onmokoworks/onmk.videosynth.01/README.md

# onmk.videosynth.01

制作中のビデオシンセ。

| フォルダ | 内容 |
|---|---|
| `emulator/` | ブラウザで動くエミュレーター、シェーダーエディタ、つまみの割り当て（`index.html` を Chrome で開く） |
| `shaders/` | シェーダーと割り当て（`index.js`） |
| `docs/` | 配線図（`wiring.html`）、パネル部品の位置（`panel_controls.json`） |
| `hardware/layout/` | パネルの配置 |
| `hardware/panel_topplates/` | 天板の図面（DXF / SVG / STL / STEP） |
| `hardware/laser_acrylic/` | アクリルのレーザーカット用データ |
| `hardware/enclosure_3dp/` | 3D プリントの箱（STL、生成スクリプト） |
| `hardware/knobs_keycaps/` | ノブとキーキャップの生成スクリプト |
| `AGENTS.md` | コーディングエージェント向けの指示書 |
