onmokoworks/onmk.videosynth.01/hardware/laser_acrylic/README.txt

アクリル 3mm レーザーカット v02（2026-10-27、配置 = layout_v08d_geisai.json：メインのトグルを左上へ＝電源、左上のノブを元のトグル位置へ）
カット線: 赤 #FF0000・線幅 0.01mm・塗りなし。刻印: 黒の文字（試し板のサイズ表示だけ）。
学校のルール（色・線幅）が違ったら Illustrator で一括置換してから .ai 保存。
00_test_coupon_130x78.svg  試し板。最初に切って、部品がはまる穴サイズを確認
01_white_matte_top_bottom_300x450.svg  白両面マット: 天板3枚＋底板3枚
02_opal_matte_LED_ring_300x450.svg     乳半両面マット: LED 層の枠3枚（幅10mm）
穴はレーザーの削れ分の補正なし（kerf 0）。試し板の結果で source/laser_layout.py --kerf を決めて作り直す。
