onmokoworks/onmk.videosynth.01/hardware/enclosure_3dp/box_main_120x140.stl

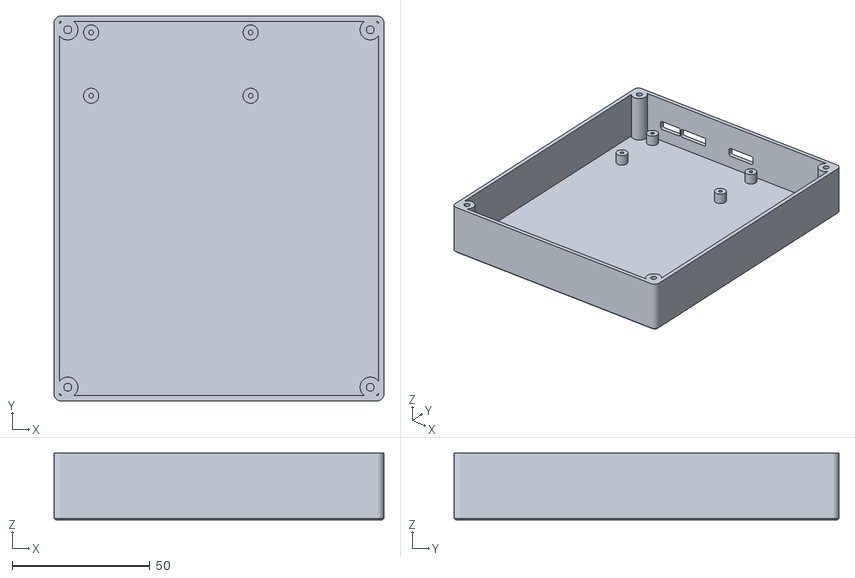
[picture p1: CAD file, 2026-10-28]
hardware/enclosure_3dp/box_main_120x140.stl
120.0 x 140.0 x 24.3
