onmokoworks/onmk.videosynth.01/hardware/panel_topplates/01_topplate_main_120x140_t3mm.step

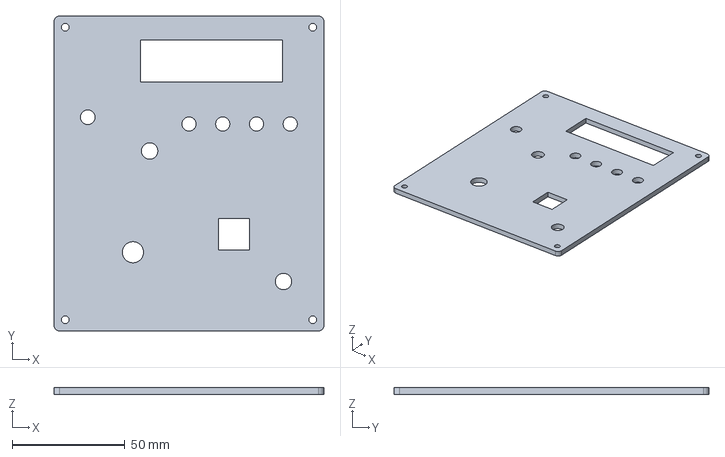
[picture p2: CAD file, 2026-10-28]
hardware/panel_topplates/01_topplate_main_120x140_t3mm.step
120.0 x 140.0 x 3.00 mm
