onmokoworks/onmk.videosynth.01/hardware/enclosure_3dp/box_faders_110x105.stl

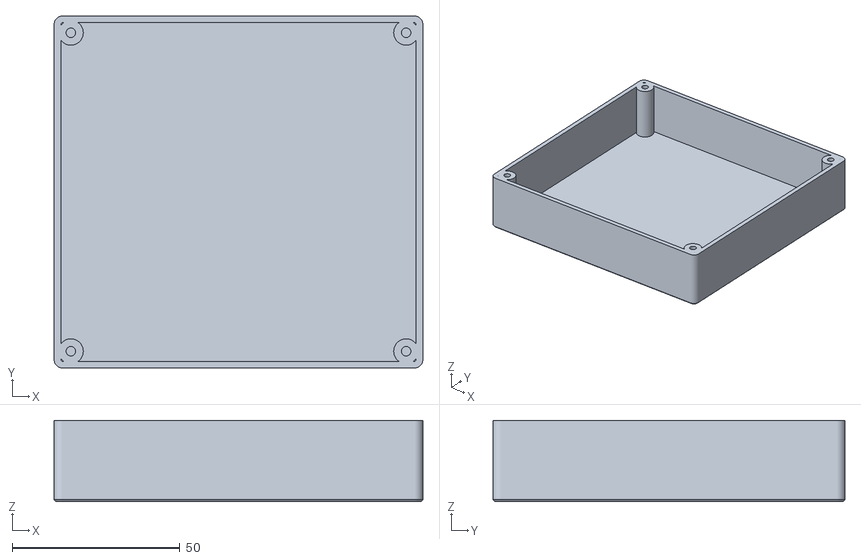
[picture p3: CAD file, 2026-10-28]
hardware/enclosure_3dp/box_faders_110x105.stl
110.0 x 105.0 x 24.3
