onmokoworks/onmk.videosynth.01/hardware/knobs_keycaps/keycap_form_v03_x2.stl

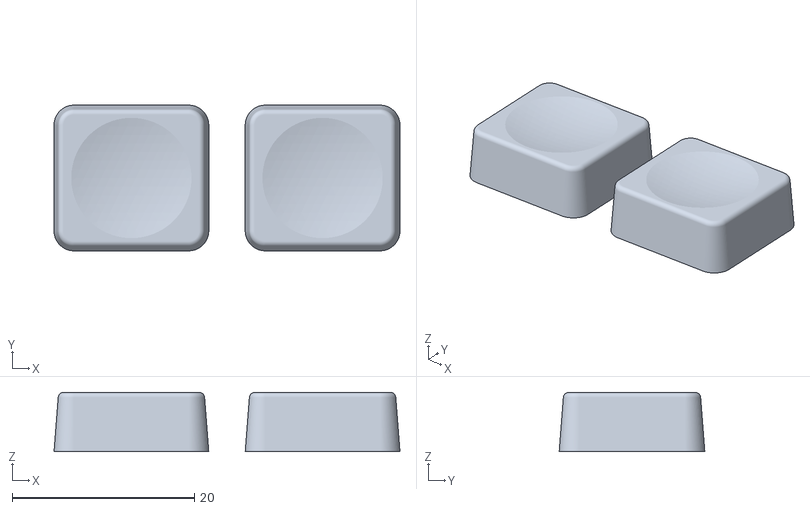
[picture p4: CAD file, 2026-10-28]
hardware/knobs_keycaps/keycap_form_v03_x2.stl
38.0 x 16.0 x 6.50
