onmokoworks/onmk.videosynth.01/hardware/panel_topplates/02_topplate_faders_110x105_t3mm.step

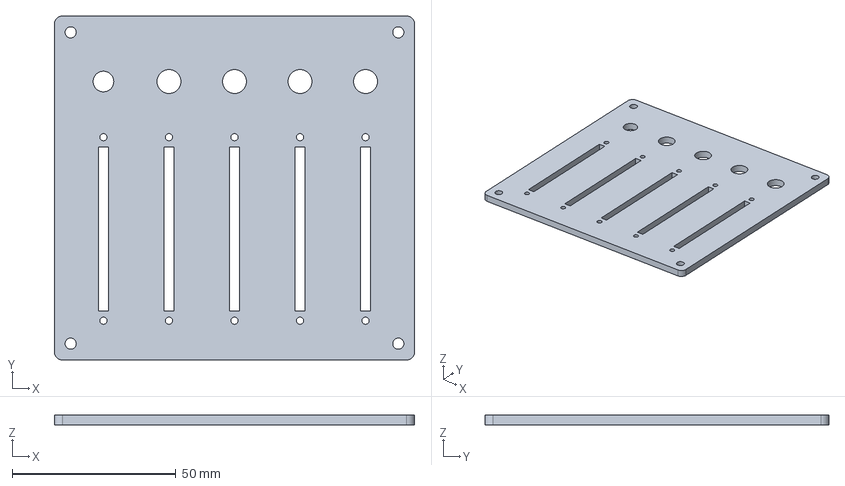
[picture p5: CAD file, 2026-10-28]
hardware/panel_topplates/02_topplate_faders_110x105_t3mm.step
110.0 x 105.0 x 3.00 mm
