onmokoworks/onmk.videosynth.01/hardware/panel_topplates/03_topplate_keys_115x80_t3mm.step

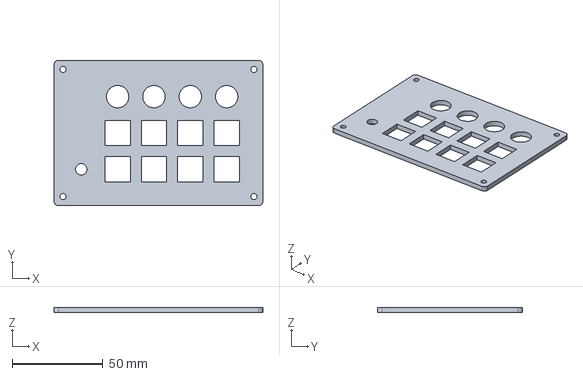
[picture p6: CAD file, 2026-10-28]
hardware/panel_topplates/03_topplate_keys_115x80_t3mm.step
115.0 x 80.0 x 3.00 mm
