onmokoworks/onmk.videosynth.01/hardware/enclosure_3dp/box_keys_115x80.stl

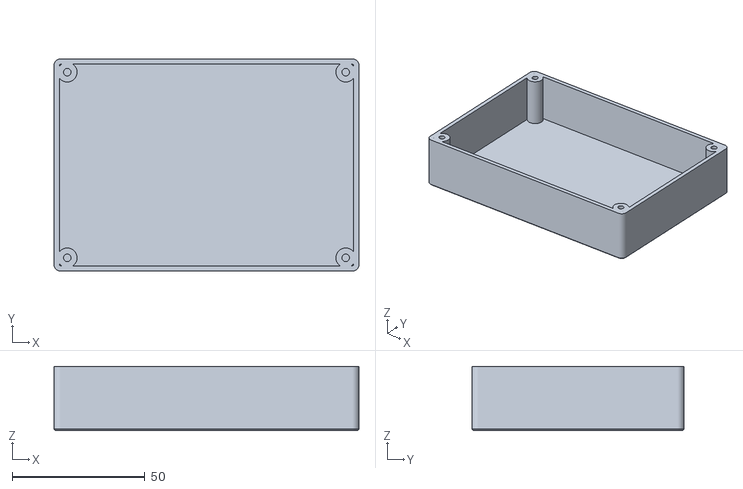
[picture p7: CAD file, 2026-10-28]
hardware/enclosure_3dp/box_keys_115x80.stl
115.0 x 80.0 x 24.3
