onmokoworks/onmk.videosynth.01/(list of files, cad)

Other CAD files:
hardware/panel_topplates/01_topplate_main_120x140_t3mm.dxf
hardware/panel_topplates/01_topplate_main_120x140_t3mm.stl
hardware/panel_topplates/02_topplate_faders_110x105_t3mm.dxf
hardware/panel_topplates/02_topplate_faders_110x105_t3mm.stl
hardware/panel_topplates/03_topplate_keys_115x80_t3mm.dxf
hardware/panel_topplates/03_topplate_keys_115x80_t3mm.stl
