onmokoworks/onmk.videosynth.01/docs/wiring.html

# Vs-01 配線図

2026-10-28 版（v3.1：パネル配置 v09・firmware/ に合わせた。キー箱のピンをヘッダ上側に集めた）。箱ごとにマイコンを入れて、DATA ケーブル（3.5mm ステレオ）で値をメインに集め、Pi Zero v1.3 が GLSL で映像を作る構成。

[フェーダー箱] Pico ＋ 74HC4067 ノブ4・フェーダー5 │ DATA 1 ケーブル：先端 = 信号（箱 → メイン）／中間 = 5V（メイン → 箱）／根元 = GND [キー箱] RP2350-PiZero キー12（上の段の4つは TAP として使う。全部ボタンなのでアナログ入力はいらない） │ DATA 3 ケーブル：同じ [メイン] Pico ノブ1・GOOD KNOB（エンコーダー）・RESET・トグル SW2 ＋ 横の箱の値をまとめる │ UART（TX と GND の2本） [メイン] Pi Zero v1.3 シェーダー → HDMI、小さい液晶（TFT）も Pi Zero が表示 [メイン] USB-C 電源入口 → POWER トグル → 5V（全部に配る）

3.3V5VGNDアナログ（ノブ・フェーダー）デジタル（キー・エンコーダー・切り替え）シリアル（UART）・液晶

図の中の 3V3 / 5V / GND の小さな札は「同じ名前の札どうしは全部つながっている」という意味（線を全部描くと見づらいので省略）。

守ること・決まりごと

- 手持ちのジャックの足番号：1 = 根元（GND）・2 = 先端（信号）・3 = 中間（5V）（10/28 にプラグを挿して確認）
- 電源を入れたままの抜き挿し OK にするため、メイン側の 5V はジャックごとに ポリスイッチ＋33Ω、信号線は両端に 2.2kΩ。挿す瞬間に線どうしが触れても、流れる電流が小さく抑えられて壊れない。モノラル（2極）のケーブルを挿してしまっても同じく守られる（ただし動かない）。
- ノブ・フェーダーの端は 3.3V につなぐ（5V はだめ）。
- 横の箱は、DATA の 5V → ショットキーダイオード → 電源入力。帯のある側を基板側に。USB を挿したまま動かしても逆流しない。
- DATA ケーブルはステレオ（3極）。ユーロラックの黄色いケーブル（モノラル）では動かない。
- 箱の柱に載せて端子を壁の穴に合わせるのは Pi Zero。メインの Pico は箱の中の空いた所に両面テープで固定。
- Pi Zero は電源を急に切られても壊れないよう読み込み専用にする（再生プログラムを入れるときに設定）。

## 1. フェーダー箱（Pico ＋ 74HC4067）

### 74HC4067 モジュール

モジュール | Pico
VCC | 3V3(OUT) 36番ピン（すぐそばに 100nF を VCC–GND 間に）
GND | GND
EN | GND（常に有効）
S0 / S1 / S2 / S3 | GP2 / GP3 / GP4 / GP5
SIG | GP26（ADC0）31番ピン

買うのは「74HC4067」（HCT ではない方）。

### ノブ・フェーダー → 74HC4067

部品 | チャンネル
ノブ 0〜3（左から） | C0 / C1 / C2 / C3
フェーダー 0〜4（左から） | C4 / C5 / C6 / C7 / C8

それぞれ3本足：片端 → 3V3、反対の端 → GND、ワイパー → チャンネル。どの足がワイパーかはテスターで確かめる（真ん中とは限らない）。回す向きが逆なら端の2本を入れ替える。

### DATA 1 ジャック

ジャック | Pico
先端（Tip） | 2.2kΩ → GP0（UART0 TX）1番ピン
中間（Ring） | ダイオード（帯が Pico 側）→ VSYS 39番ピン
根元（Sleeve） | GND

## 2. キー箱（RP2350-PiZero）

GP 番号は RP2350 のピン番号。40ピンの物理番号や Pi の GPIO 番号とは別物なので、基板の印刷（GP○○）を見てつなぐ。

### キー・TAP

部品 | RP2350-PiZero
上の段（左から）＝ TAP 0〜3 | GP5 / GP7 / GP9 / GP21
真ん中の段（左から）＝ キー 0〜3 | GP18 / GP8 / GP1 / GP20
下の段（左から）＝ キー 4〜7 | GP22 / GP23 / GP24 / GP11

10/29 に短い線で配線し直した実際のピン（1つずつ押して確認済み）。全部のキーの上側の足を GND の数珠つなぎ、下側の足をそれぞれの GP へ。GND は各段（上・中・下）からボードの GND へ1本ずつ（段の間の渡り線だけだと切れやすい。10/28 に上・中段が無反応→各段直結で解決、12キー全部 OK）。

スイッチの片足 → GP、もう片足 → GND。抵抗はいらない（内蔵のプルアップを使う）。基板にその GP が出ていなければ、空いている別の GP に変えて教えてください（プログラム側で合わせます）。

### DATA 3 ジャック

ジャック | RP2350-PiZero
先端 | 2.2kΩ → GP0（UART0 TX）
中間 | ダイオード（帯が基板側）→ 5V ピン
根元 | GND

## 3. メイン（Pico ＋ Pi Zero v1.3）

### Pico：メインのつまみ

部品 | Pico
ノブ（1つだけ）ワイパー | GP26（ADC0）31番
トグル SW2（右下のもう1つのトグル） | GP19 25番 ／ もう片足 GND
ノブの両端 | 3V3(OUT) 36番 と GND
GOOD KNOB（RE160F）A / B | GP16 / GP17 21・22番
GOOD KNOB の C（共通） | GND（C の足は端子図とテスターで確認）
RESET キー | GP18 24番 ／ もう片足 GND

### Pico：DATA ジャック

ジャック | つなぎ先
DATA 1 先端（フェーダー箱から） | 2.2kΩ → GP1（UART0 RX）2番
DATA 3 先端（キー箱から） | 2.2kΩ → GP5（UART1 RX）7番
DATA 1・3 中間 | 5V → ポリスイッチ MF-RX020 → 33Ω（1/2W） → 中間（ジャックごとに1組）
DATA 1・3 根元 | GND
DATA 7・8 | 何もつながない（予備）

### Pico → Pi Zero

Pico | Pi Zero（40ピン）
GP0（UART0 TX）1番 | GPIO15 / RXD 10番ピン
GND | GND 6番ピン

### 小さい液晶（ST7789 2.25"）→ Pi Zero

液晶 | Pi Zero（40ピン）
VCC | 3V3 17番
GND | GND 20番
SCL / SCK | GPIO11 23番
SDA / MOSI | GPIO10 19番
CS | GPIO8 / CE0 24番
DC | GPIO25 22番
RES | GPIO24 18番
BLK（バックライト） | GPIO18 12番（つながなくても点く型が多い）

シェーダー名や GOOD の値は Pi Zero が知っているので、液晶も Pi Zero が表示する。

### 電源

から | へ
USB-C 電源モジュール 5V | POWER トグルの片側
POWER トグルのもう片側（＝5V） | Pi Zero 5V 2番、メイン Pico VSYS 39番、DATA 用ポリスイッチ
USB-C 電源モジュール GND | 全部の GND

5V 2A 以上の USB 充電器。電源の入口のそばに 10〜47µF のコンデンサがあると安定する。
Pi Zero を 5V ピンから給電している間は、Pi Zero の micro USB には何も挿さない。

## 4. 送るデータの形（プログラム用）

どこ → どこ | 形 | 頻度
フェーダー箱 → メイン | F,k2,k3,k4,k5,f0,f1,f2,f3,f4\n（0〜4095、ノブは全体の番号 2〜5） | 50 回/秒
キー箱 → メイン | K,<12桁の0/1>\n（キー0〜11、押している所が 1。0〜3 が TAP） | 変化したとき＋10 回/秒
メイン Pico → Pi Zero | V,k0..k5,f0..f4,keys,taps,enc,reset,sw2\n（17項目。ノブ・フェーダーは 0〜1、k1 は 0.5 固定、enc は回した段数の合計。u_good = enc/24） | 60 回/秒

どれも 115200bps・8N1。Pi Zero v1.3 の GPIO15 は本物の UART（ttyAMA0）：enable_uart=1、シリアルコンソールは切る。

読み取りのコツ（プログラム側）：74HC4067 は切り替えて 20µs 待ち、1回捨ててから数回平均。エンコーダーは A/B の状態変化で数える。

## 5. 買い足すもの

- 74HC4067 モジュール ×1（予備込みで2）— フェーダー箱
- USB-C 電源モジュール（5V を取り出すだけ） ×1 — 電源入口
- 2.2kΩ 抵抗 ×4、33Ω 抵抗（1/2W） ×2、ショットキーダイオード（1N5817 など）×2、100nF ×1、10〜47µF ×2〜3
- メス-メスのジャンパ線、細い配線用の線
- （手持ち）Pico ×2、RP2350-PiZero、Pi Zero v1.3（10/28 着）、ポリスイッチ MF-RX020、3.5mm ステレオジャック
