onmokoworks/onmk.videosynth.01/(commit log)

2026-10-28 Vs-01: emulator, shader editor and mapping, shaders, wiring diagrams, hardware files
    - emulator/: browser emulator of the three panels (desk view, patch cables, POWER, GOOD KNOB),
    GLSL editor with live compile and highlighting, map tab for p_* params
    - shaders/: GOOD, BARS, FEEDBACK, PLASMA (GLSL ES 1.00, u_good everywhere)
    - docs/: wiring.html (v2, after review), panel_controls.json/js
    - hardware/: layout v08d, 3 mm top plates, laser sheets v02, 3D-printed boxes, knob/keycap scripts
    - AGENTS.md: shader contract, GOOD KNOB rules, mapping rules, tasks
    [01_topplate_main_120x140_t3mm.dxf, 01_topplate_main_120x140_t3mm.step, 01_topplate_main_120x140_t3mm.stl, 02_topplate_faders_110x105_t3mm.dxf, 02_topplate_faders_110x105_t3mm.step, 02_topplate_faders_110x105_t3mm.stl, 03_topplate_keys_115x80_t3mm.dxf, 03_topplate_keys_115x80_t3mm.step]
2026-10-28 README を日本語に
2026-10-28 README を中身の一覧だけに
2026-10-28 エミュレーター：四隅のネジを六角、フェーダーの M2 ネジを表示
2026-10-28 Add v09 MicroPython control-board firmware and host tests
2026-10-28 TRUCHET main shader (woven layers, scrolling, flip cards); wiring v3 for panel layout v09
2026-10-28 wiring: keys box pins moved to the top rows of the header
2026-10-28 wiring: note the jack pin numbers (1 sleeve, 2 tip, 3 ring)
2026-10-28 wiring: keys box GND goes from every row to the board; 12 keys verified
2026-10-29 wiring: key layout (front/back) and RP2350-PiZero header map diagram
2026-10-29 keys: pins as rewired on 10/29 (GP5/7/9/21, 18/8/1/20, 22/23/24/11), UART RX parked on GP13
2026-10-29 TRUCHET: balls hang under the lower edge of their band (cable-car), measured along the real hanging path
2026-10-29 wiring: Pi Zero header diagram (top view, pins used highlighted)
